dbsqp/bluetooth-reebok-57e/documentation/bike-power-traces.pdf

# ri I

10, o(20

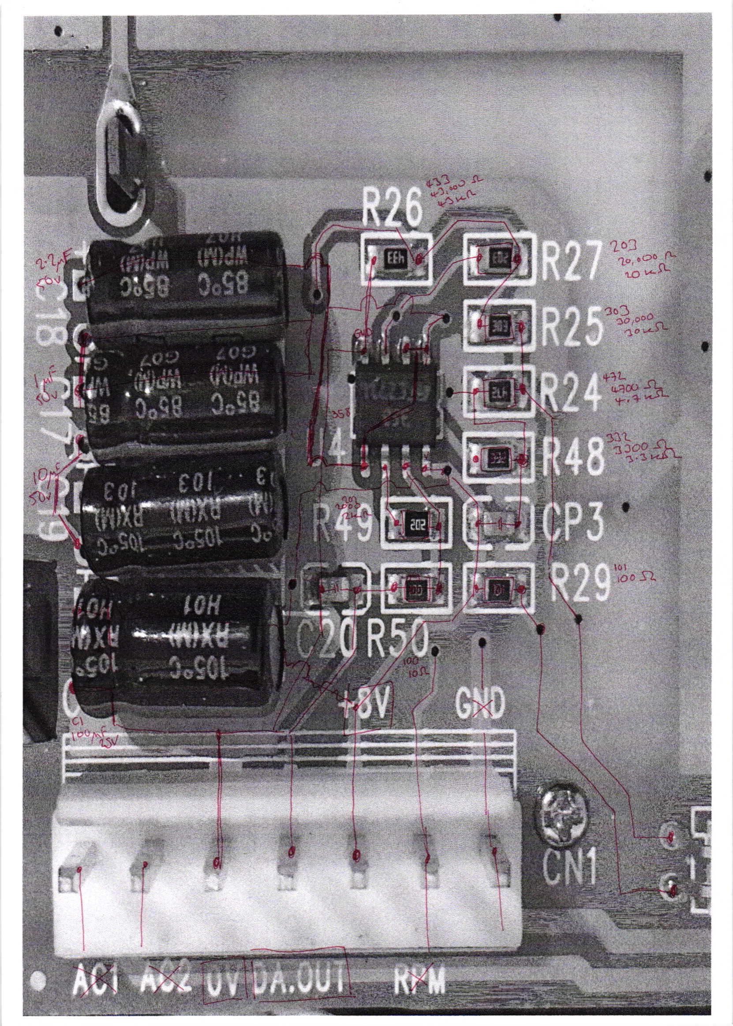
[picture p10: page 1]

*r

ri,

i(i

1a v-

L

il

il

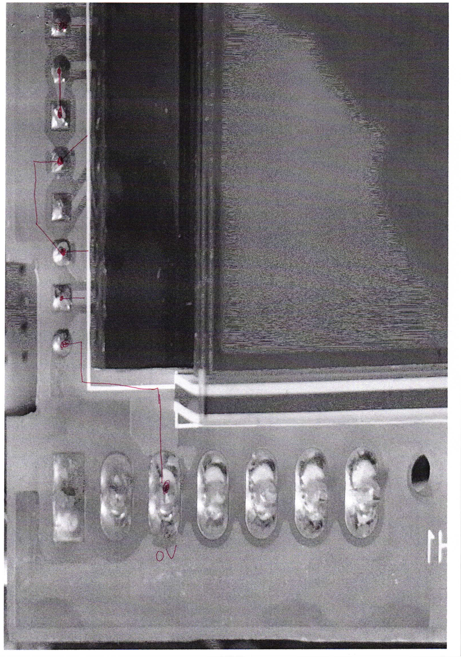
[picture p11: page 2]
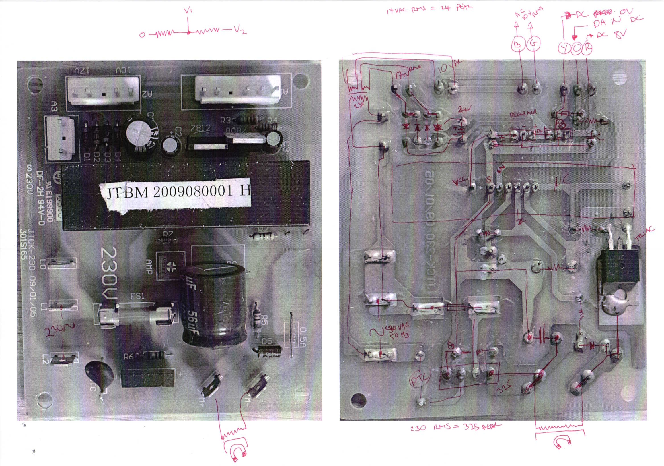
[picture p12: page 3]

+

-l7!>

T.t] @

f

I'

.<.J, I
{I

{-L

+'
o

-,

1

a -r .Lt(
:<. '..

i:

,C

.J

Lf

\q'- '

\.

lr
!(t
'ir

# qa) i

-li
