dbsqp/bluetooth-reebok-57e/documentation/Oscilloscope/ALL0000-oc-low/F0000TEK.pdf

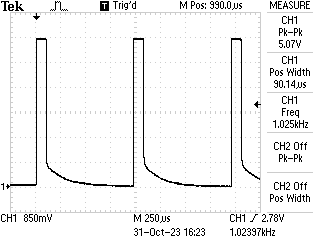
[picture p13: figure]
