dbsqp/bluetooth-reebok-57e/documentation/Oscilloscope/ALL0001-oc-high/F0001TEK.pdf

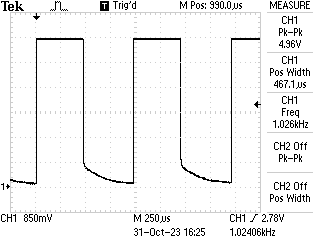
[picture p14: figure]
