dbsqp/bluetooth-reebok-57e/documentation/Oscilloscope/ALL0002-reed/F0002TEK.pdf

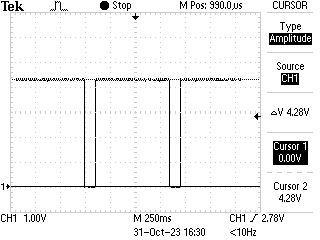
[picture p15: figure]
