dbsqp/bluetooth-reebok-57e/documentation/apple-watchos-bluetooth-csc.jpg

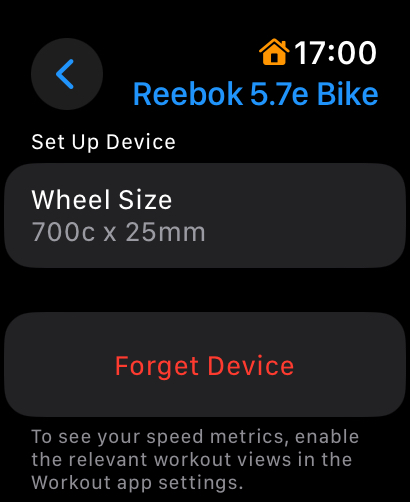
documentation/apple-watchos-bluetooth-csc.jpg
