dbsqp/bluetooth-reebok-57e/documentation/bike-electromagnet.jpeg

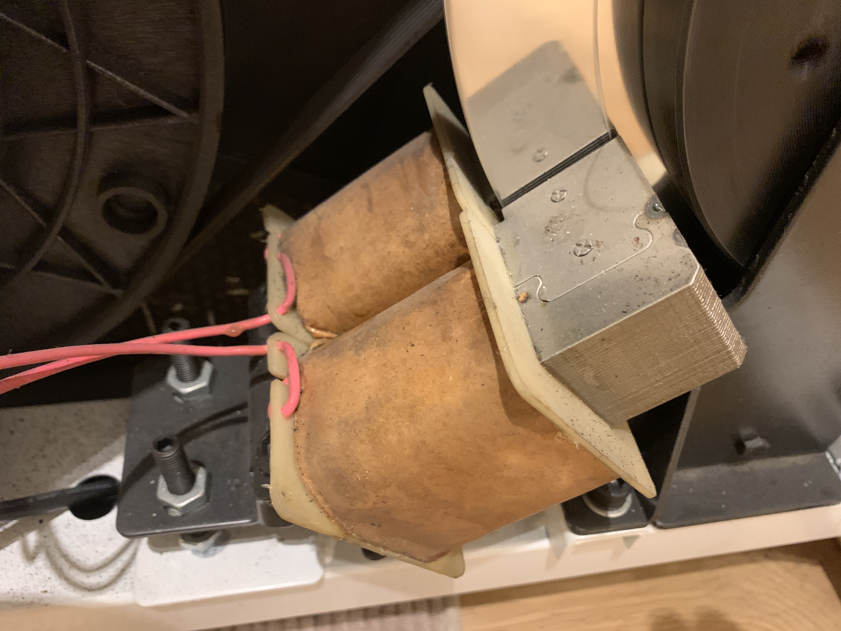
documentation/bike-electromagnet.jpeg
