dbsqp/bluetooth-reebok-57e/documentation/bike-mcu-CN3-daughter.jpeg

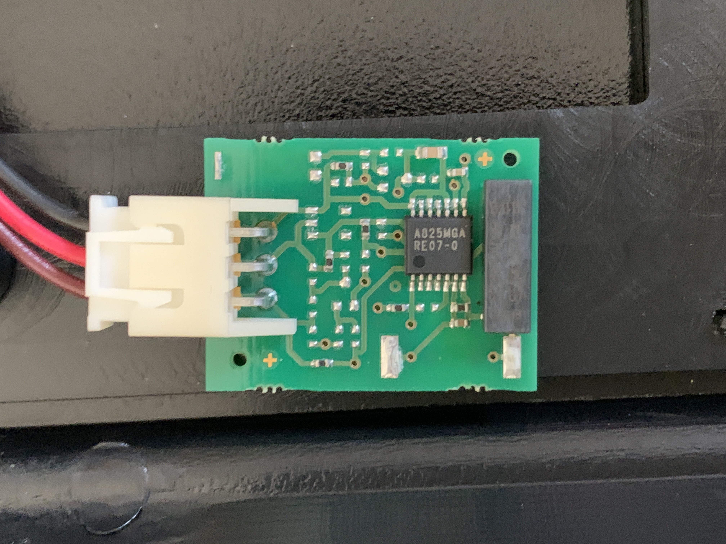
documentation/bike-mcu-CN3-daughter.jpeg
