dbsqp/bluetooth-reebok-57e/documentation/bike-mcu-CN4-serial.jpeg

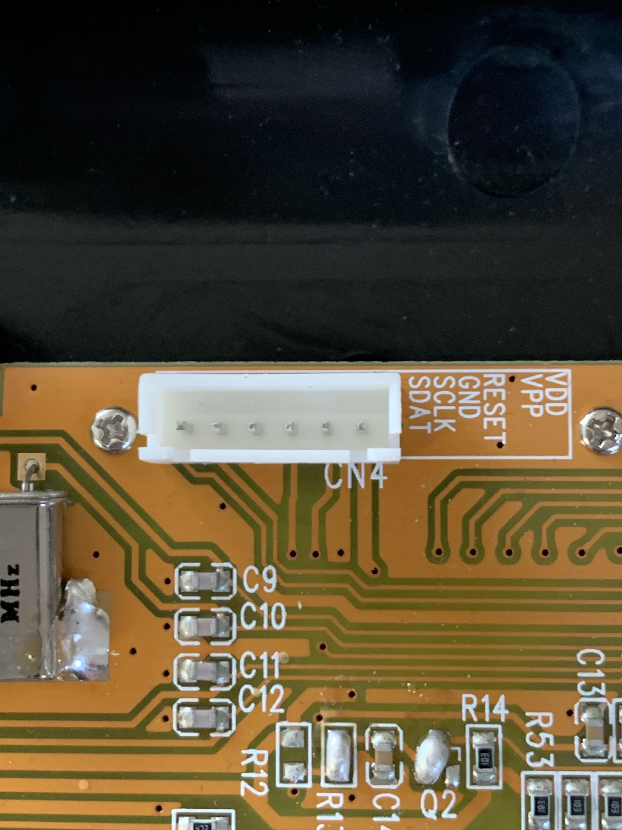
documentation/bike-mcu-CN4-serial.jpeg
