dbsqp/bluetooth-reebok-57e/documentation/bike-mcu-front.jpg

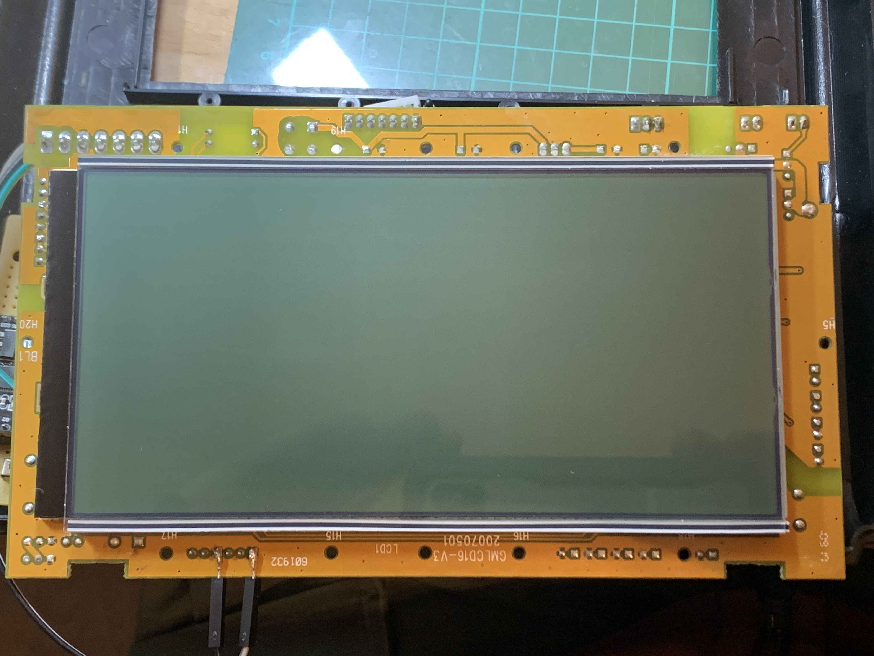
documentation/bike-mcu-front.jpg
