dbsqp/bluetooth-reebok-57e/documentation/bike-mcu-opamp-caps.jpeg

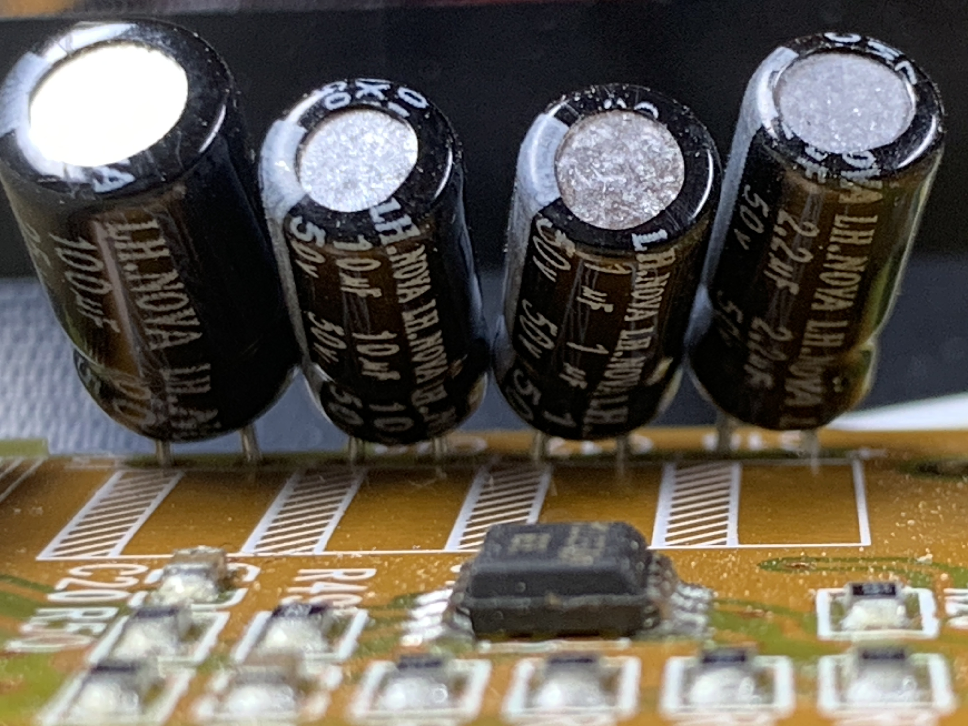
documentation/bike-mcu-opamp-caps.jpeg
