dbsqp/bluetooth-reebok-57e/documentation/bike-mcu-opamp-trace-front.jpg

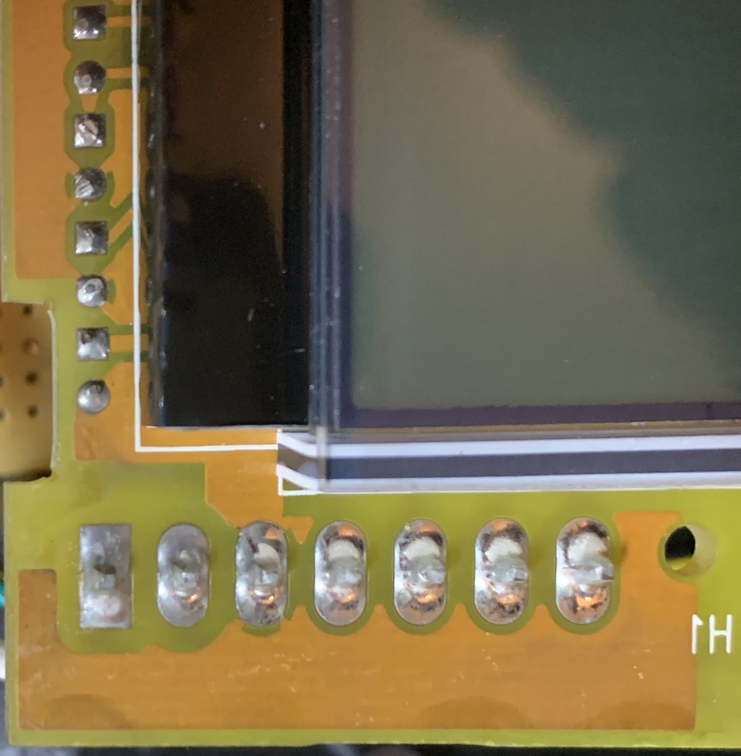
documentation/bike-mcu-opamp-trace-front.jpg
