dbsqp/bluetooth-reebok-57e/documentation/bike-mcu-opamp.jpg

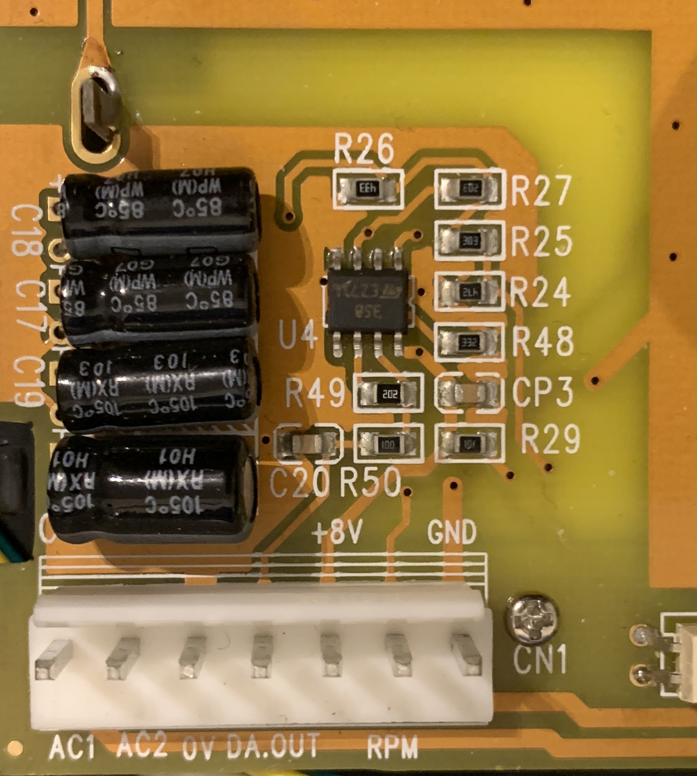
documentation/bike-mcu-opamp.jpg
