dbsqp/bluetooth-reebok-57e/documentation/bike-mcu-optio-P621-GR.jpg

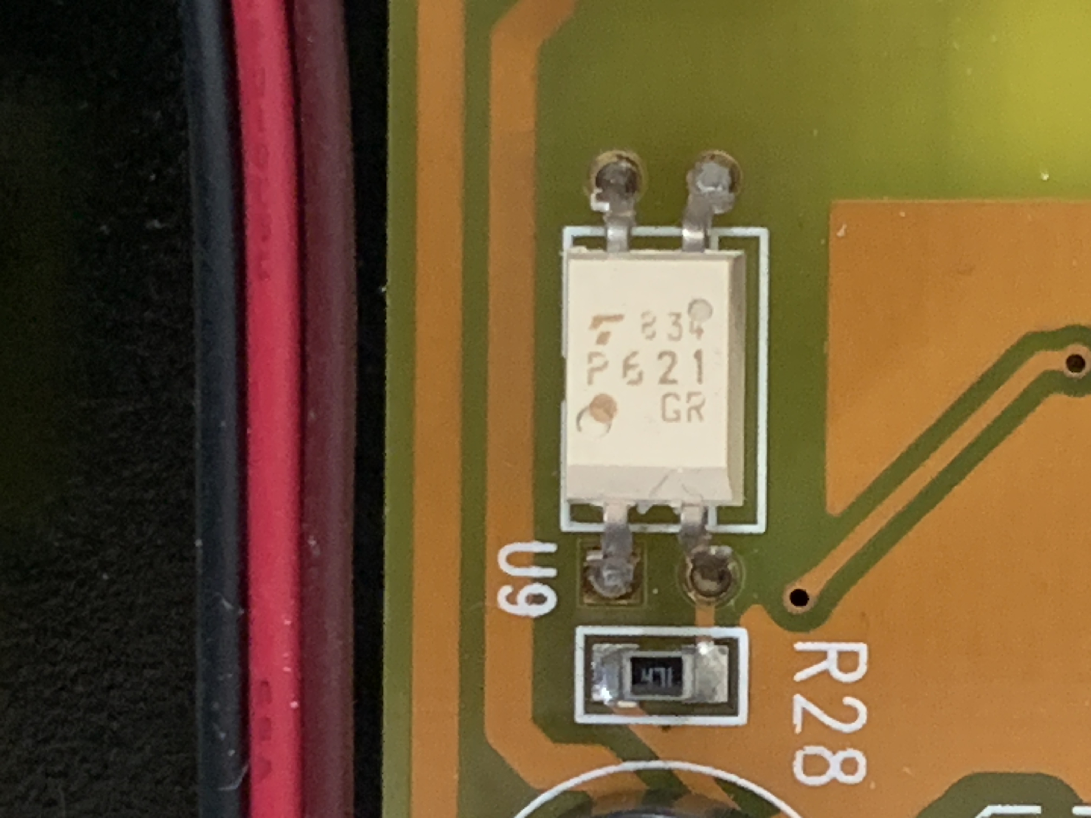
documentation/bike-mcu-optio-P621-GR.jpg
