dbsqp/bluetooth-reebok-57e/documentation/bike-mcu-regulator-7805.jpg

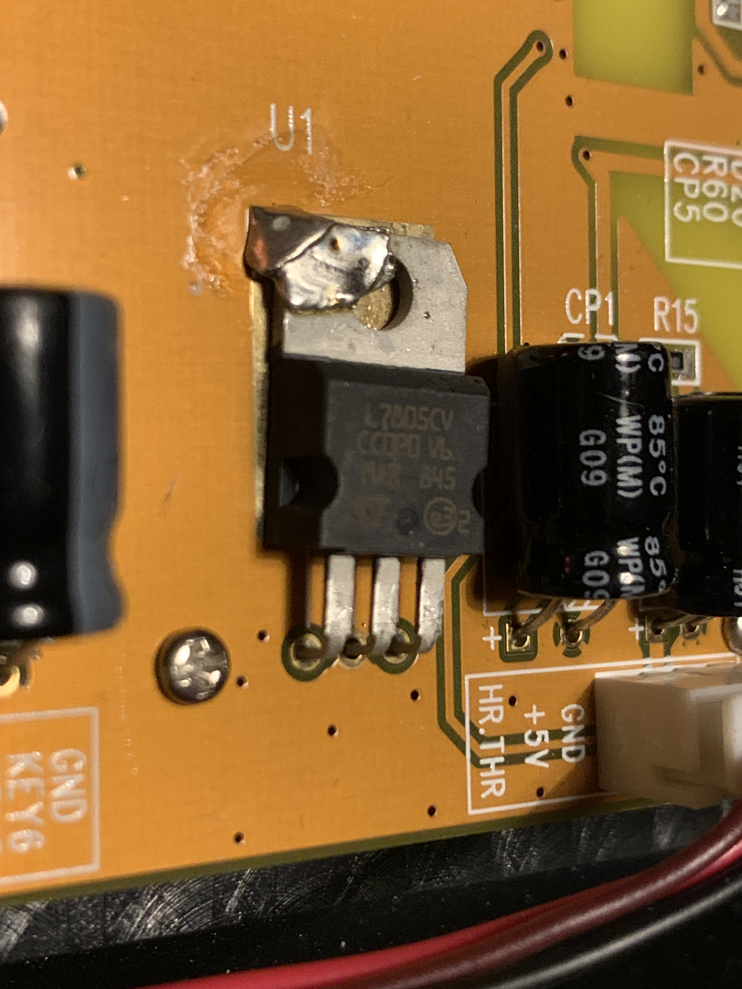
documentation/bike-mcu-regulator-7805.jpg
