dbsqp/bluetooth-reebok-57e/documentation/bike-mcu-signal-oc-high.jpeg

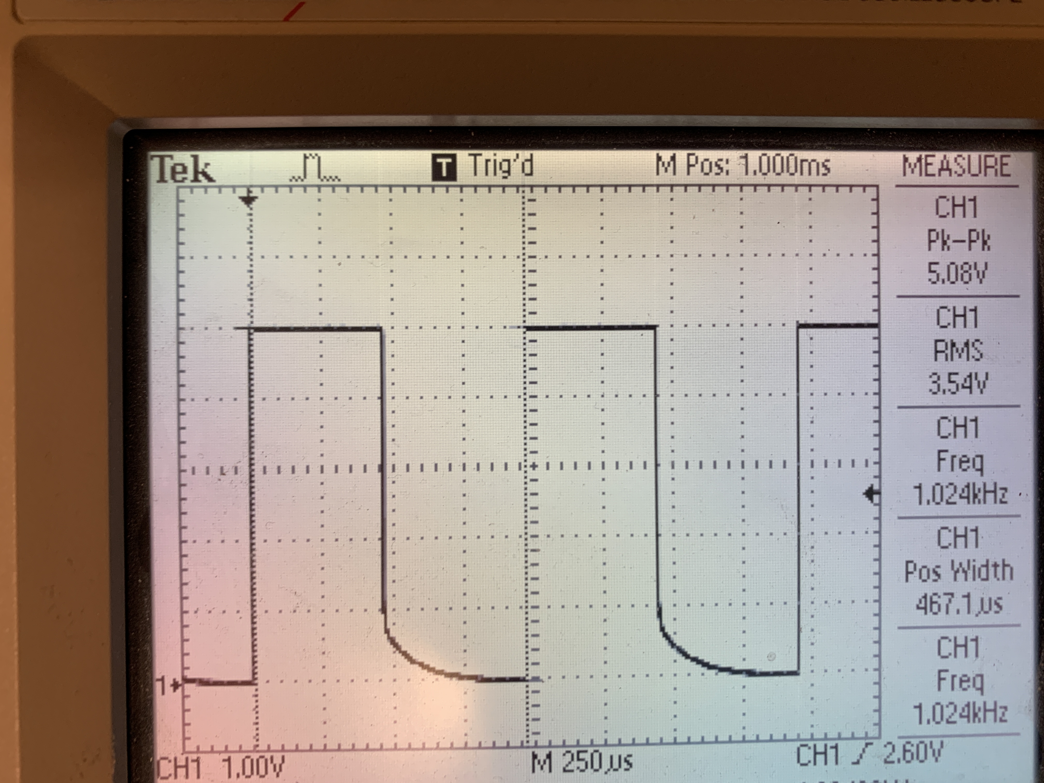
documentation/bike-mcu-signal-oc-high.jpeg
