dbsqp/bluetooth-reebok-57e/documentation/bike-mcu-signal-oc-low.jpeg

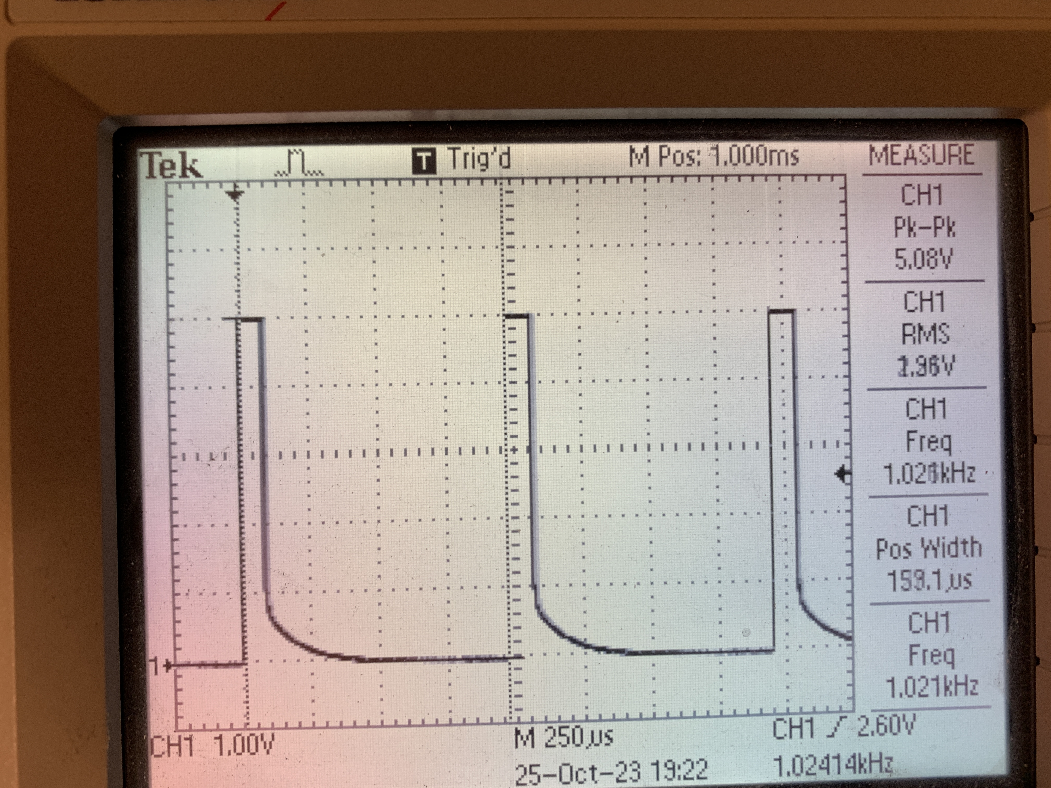
documentation/bike-mcu-signal-oc-low.jpeg
