dbsqp/bluetooth-reebok-57e/documentation/bike-mcu-signal-reed.jpg

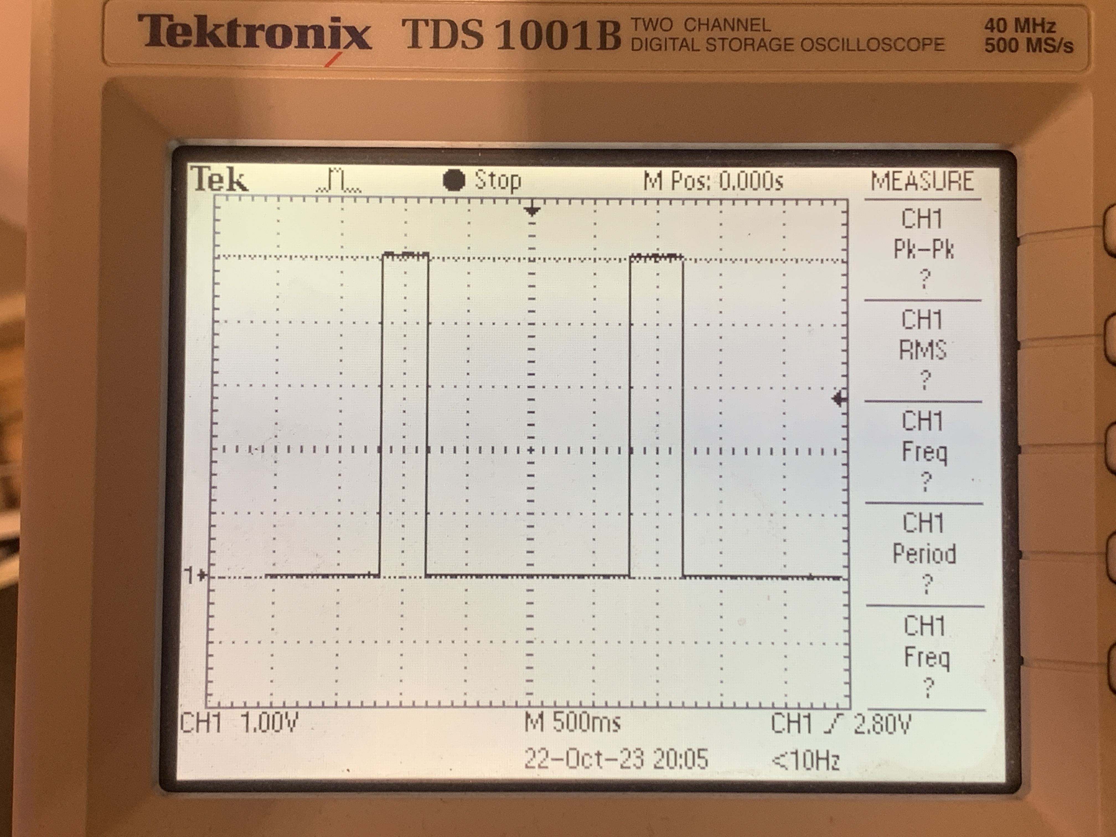
documentation/bike-mcu-signal-reed.jpg
