dbsqp/bluetooth-reebok-57e/documentation/bike-overview-full.png

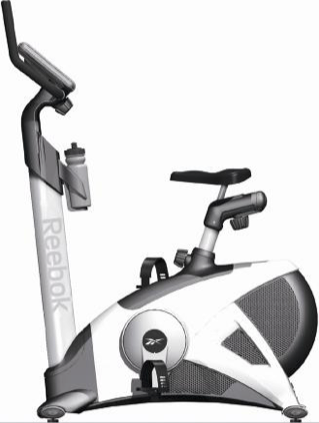
documentation/bike-overview-full.png
