dbsqp/bluetooth-reebok-57e/documentation/bike-overview.jpeg

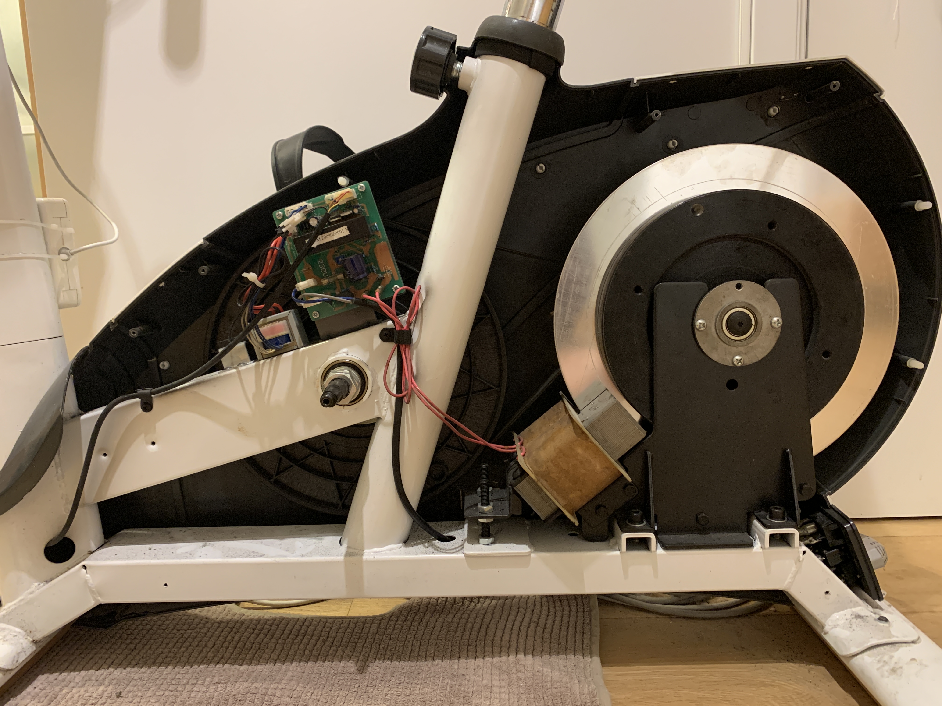
documentation/bike-overview.jpeg
