dbsqp/bluetooth-reebok-57e/documentation/bike-power-all.jpeg

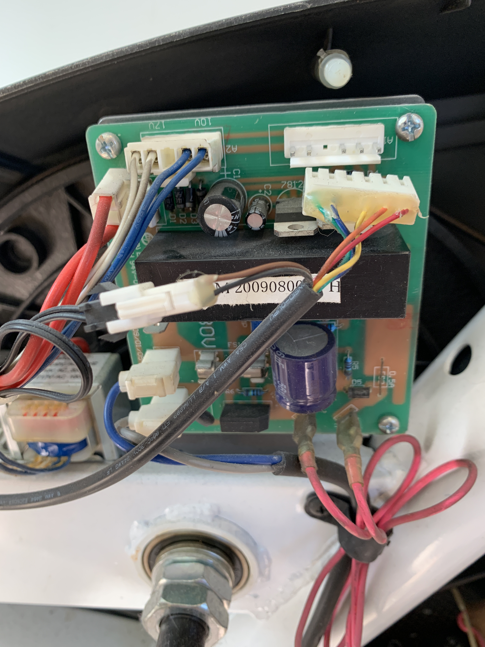
documentation/bike-power-all.jpeg
