dbsqp/bluetooth-reebok-57e/documentation/bike-power-front.jpeg

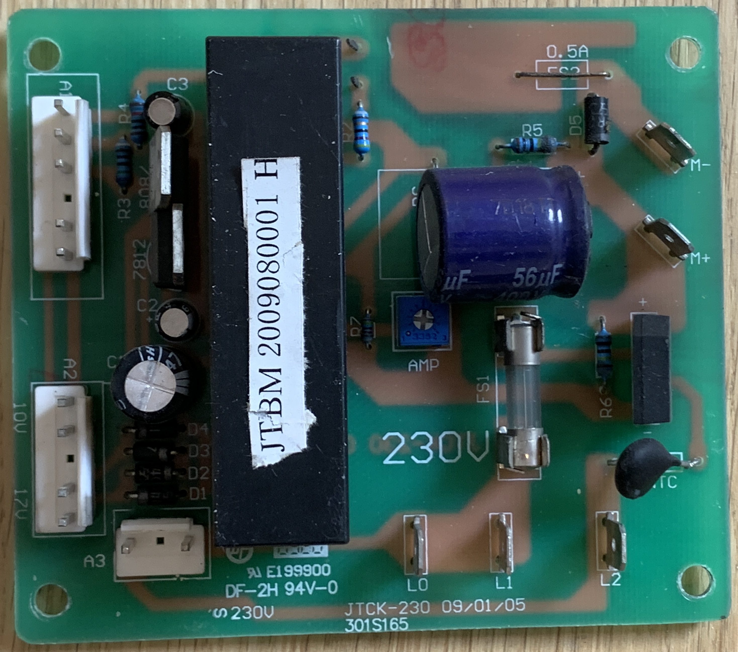
documentation/bike-power-front.jpeg
