dbsqp/bluetooth-reebok-57e/documentation/bike-power-reverse.jpeg

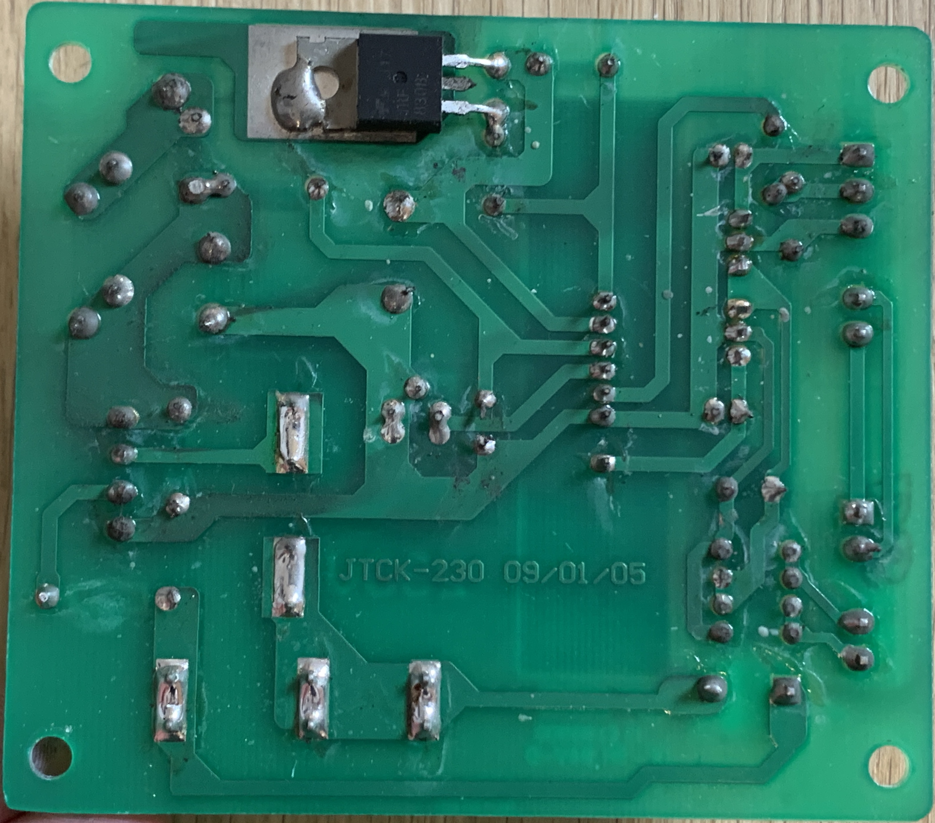
documentation/bike-power-reverse.jpeg
