dbsqp/bluetooth-reebok-57e/documentation/bike-power-trace-front.jpeg

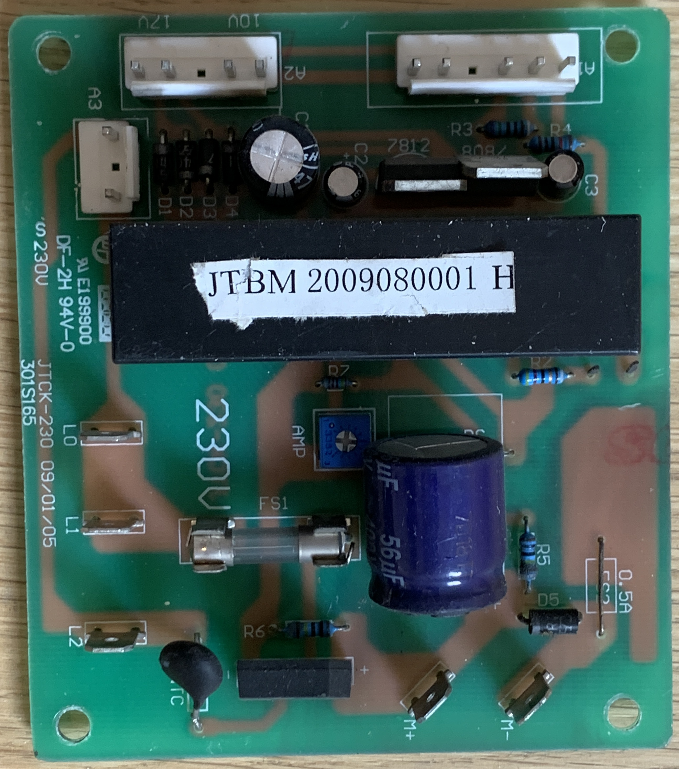
documentation/bike-power-trace-front.jpeg
