dbsqp/bluetooth-reebok-57e/documentation/bike-reed.jpeg

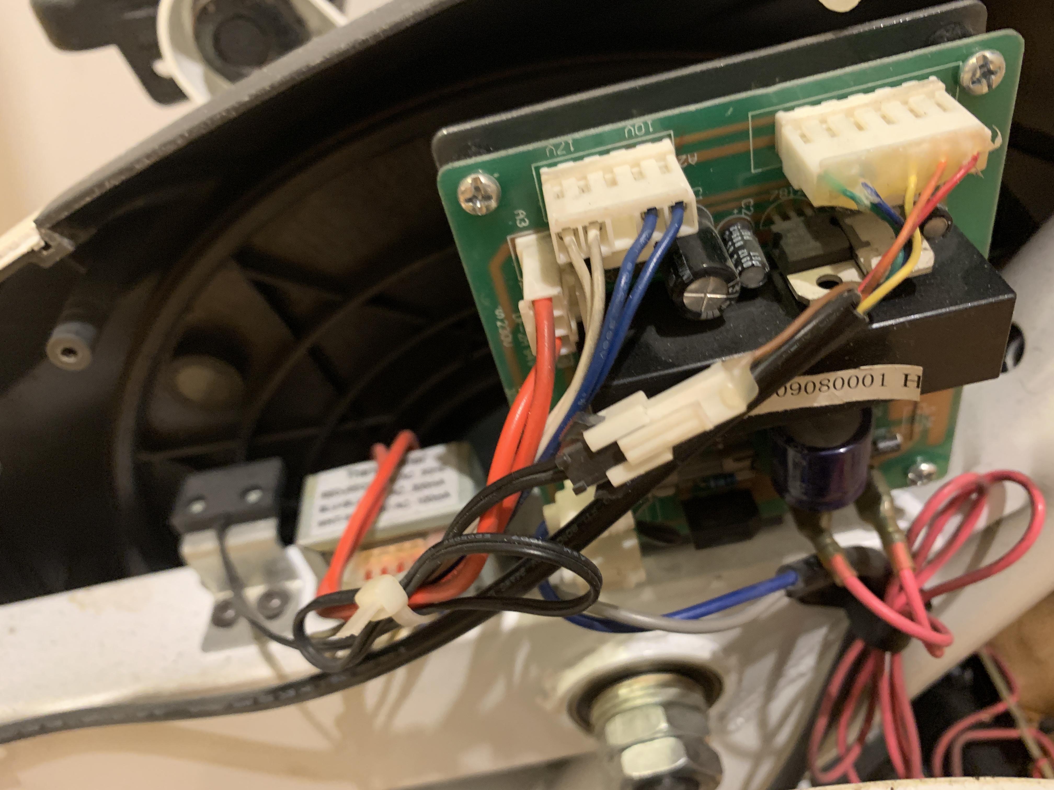
documentation/bike-reed.jpeg
