dbsqp/bluetooth-reebok-57e/documentation/comparison-bike.jpeg

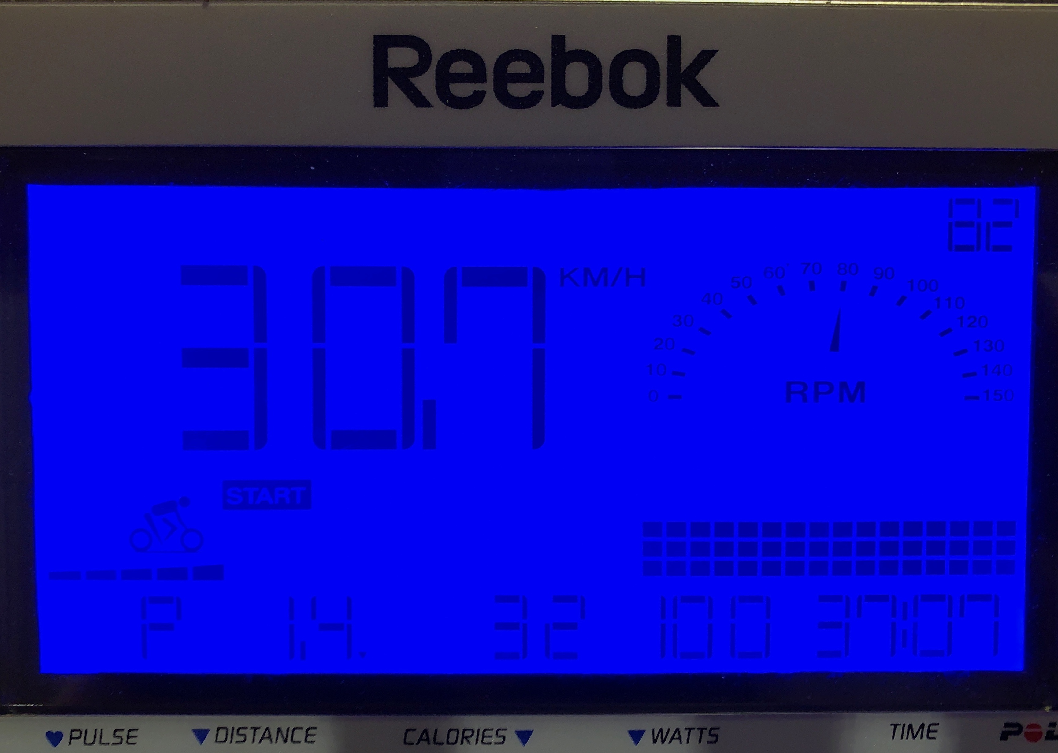
documentation/comparison-bike.jpeg
