dbsqp/bluetooth-reebok-57e/documentation/comparison-watch.jpeg

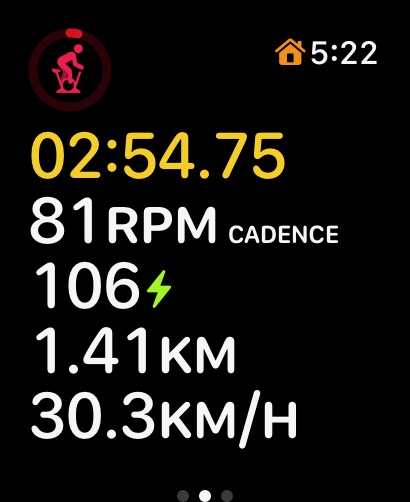
documentation/comparison-watch.jpeg
