dbsqp/bluetooth-reebok-57e/documentation/interface-front-mcu.jpeg

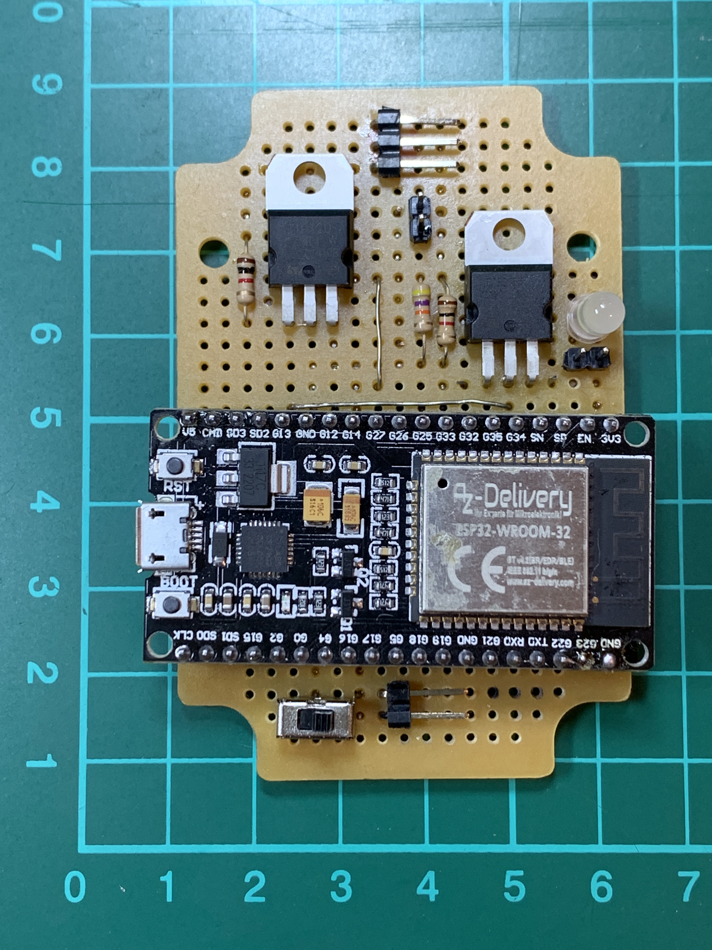
documentation/interface-front-mcu.jpeg
