dbsqp/bluetooth-reebok-57e/documentation/interface-front.jpeg

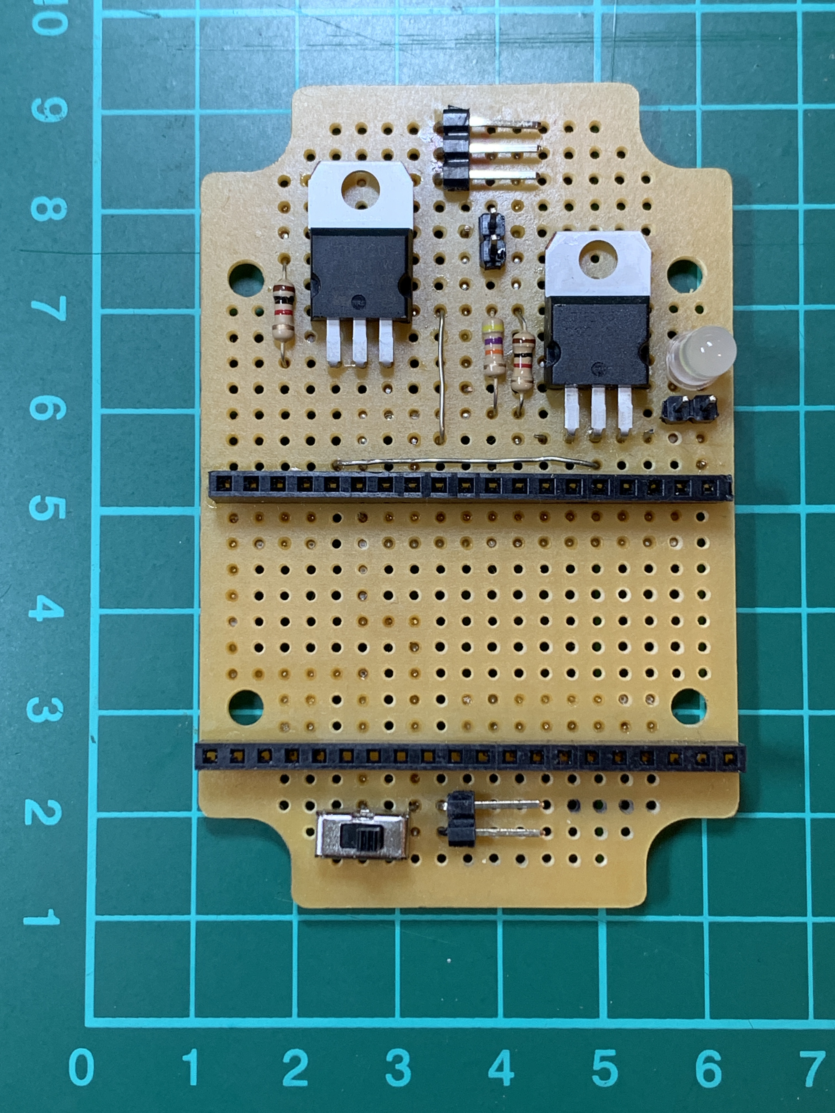
documentation/interface-front.jpeg
