dbsqp/bluetooth-reebok-57e/documentation/interface-reverse.jpeg

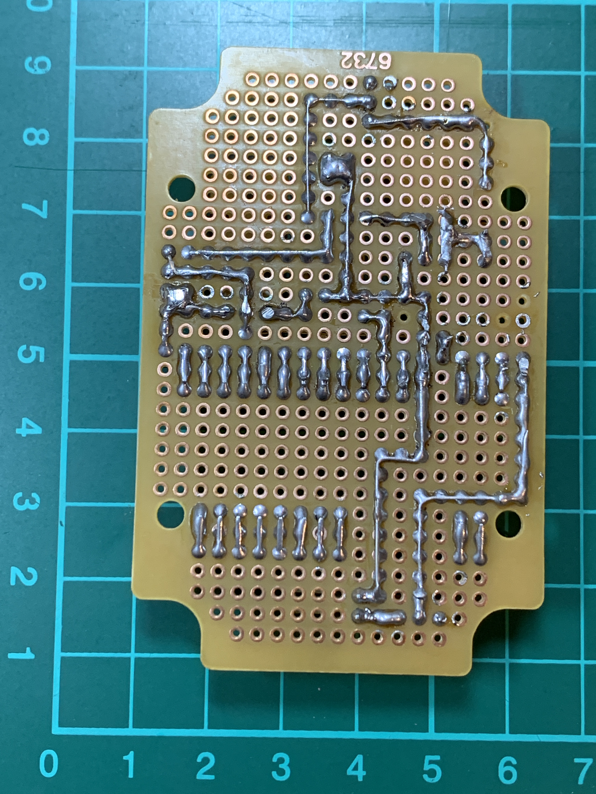
documentation/interface-reverse.jpeg
