dbsqp/bluetooth-reebok-57e/documentation/debug-workout-details.jpg

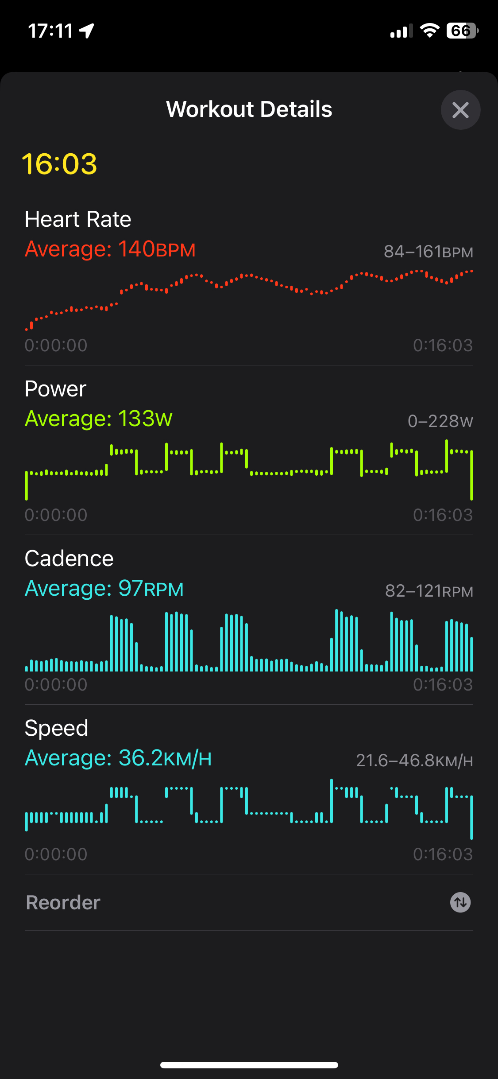
documentation/debug-workout-details.jpg
