dbsqp/bluetooth-reebok-57e/documentation/bike-exploded-edit.pdf

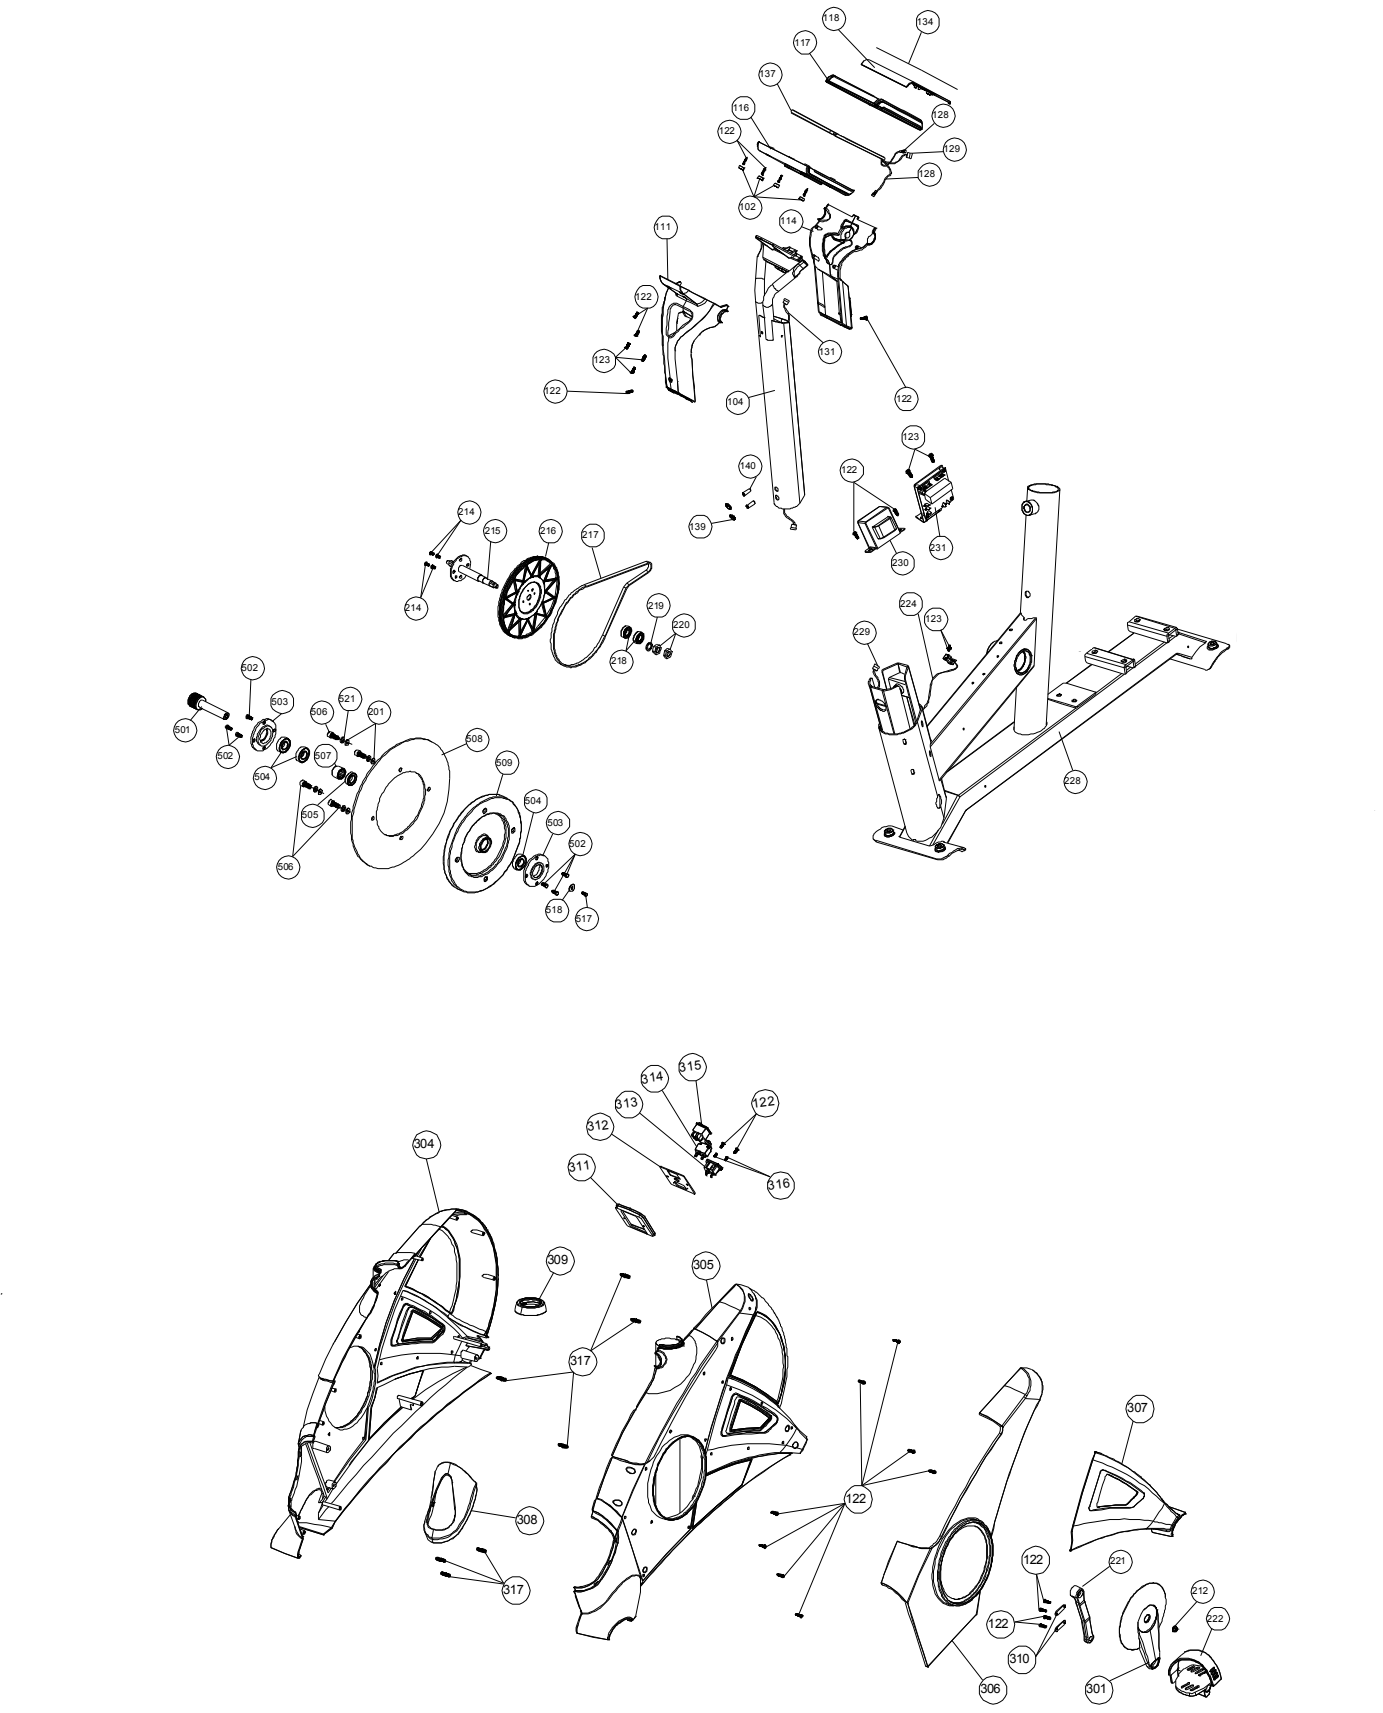
[picture p43: page 1]
