dbsqp/bluetooth-reebok-57e/documentation/bike-exploded-full.pdf

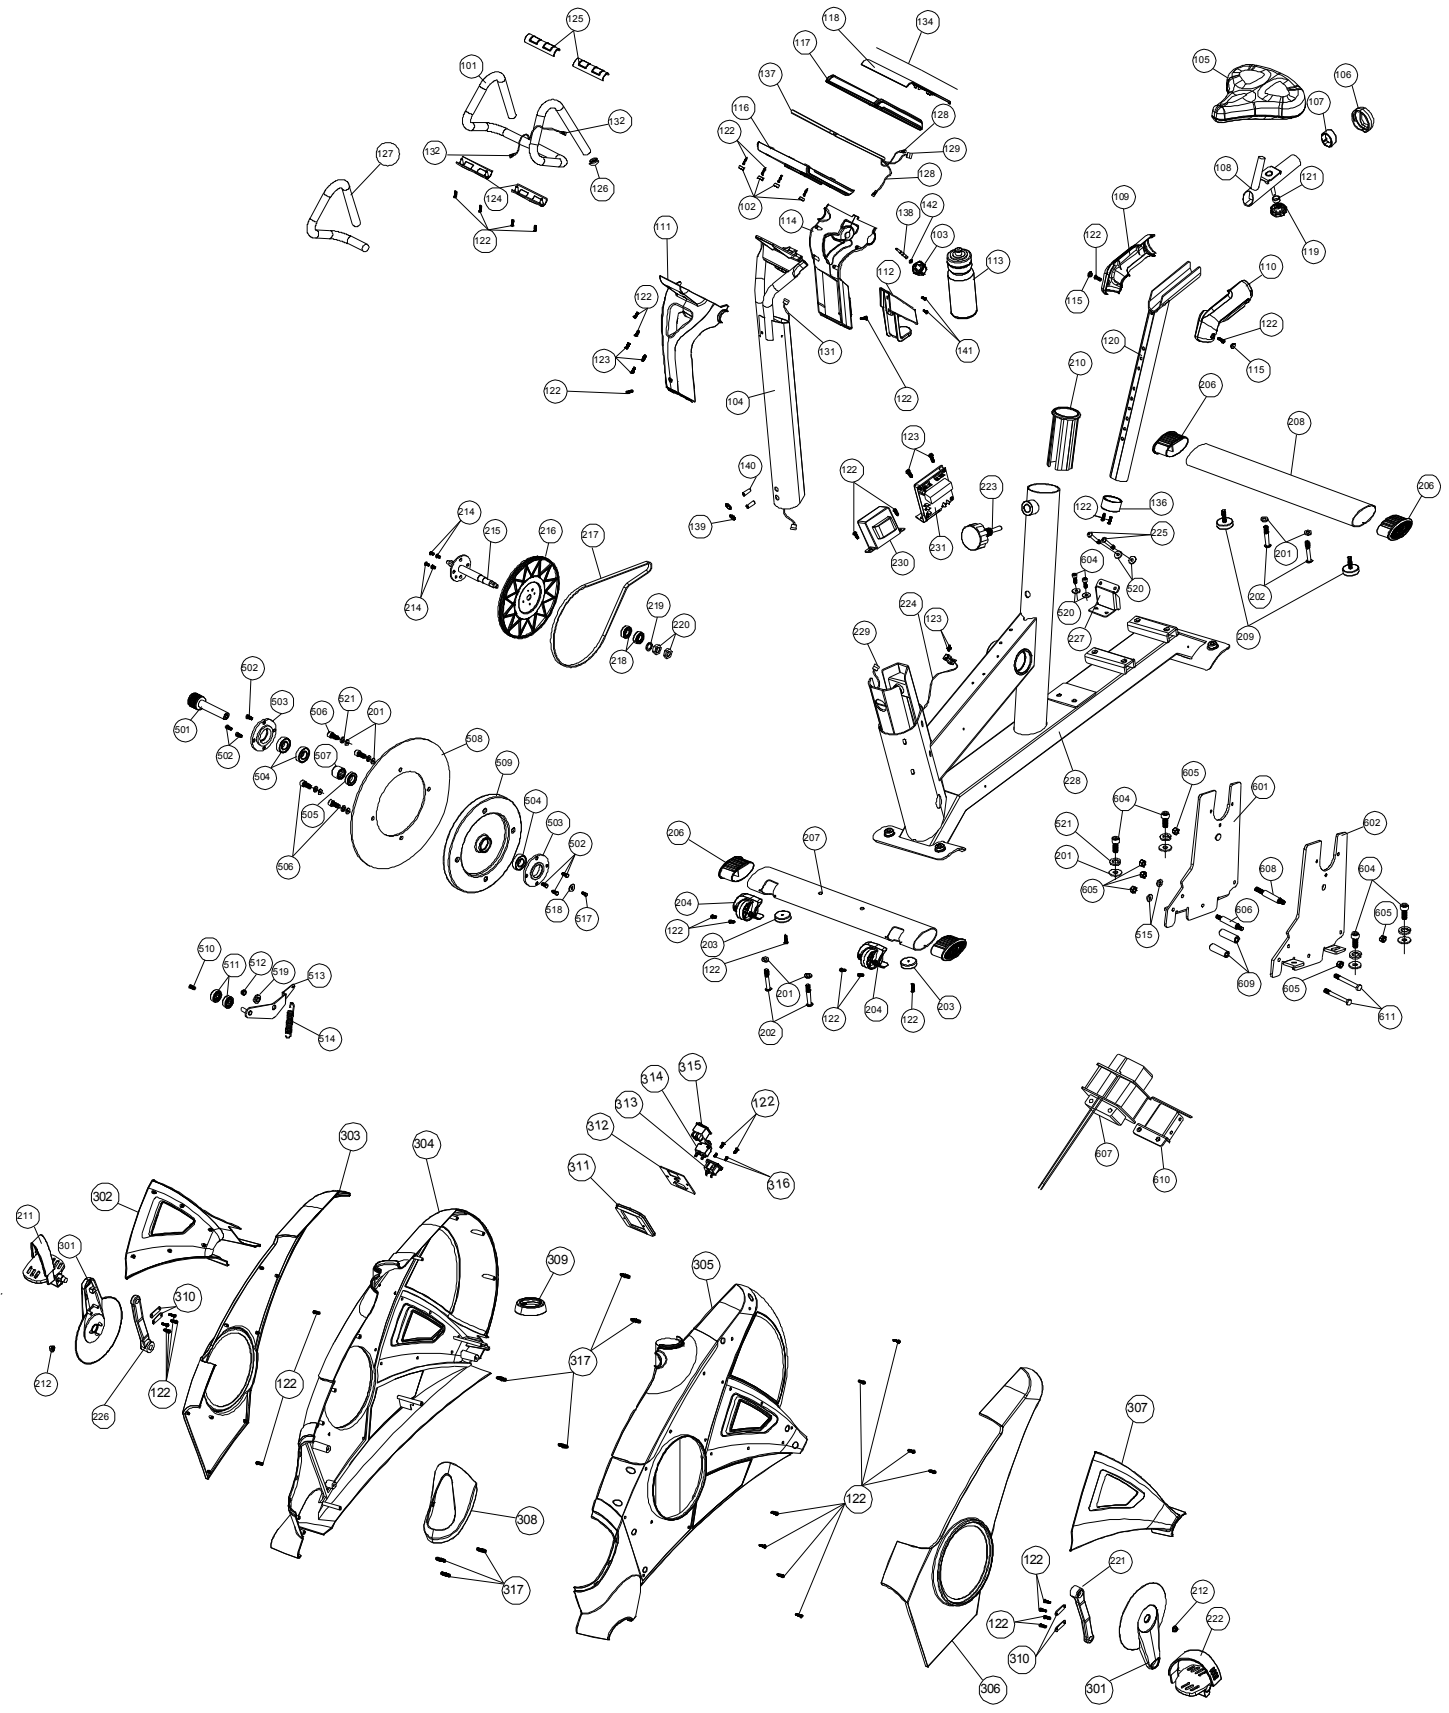
[picture p44: page 1]
