dbsqp/bluetooth-reebok-57e/(commit log)

2023-10-13 Update and rename Hall_Sensor_FTMS_server.ino to esp32-ftms-server-reebok-57e.ino
    Update filename and header info
2023-10-13 Rename esp32-ftms-server-reebok-57e.ino to ftms-reebok-57e.ino
    shorten name
2023-10-21 added power service
2023-10-21 power and cadence via CP service
2023-10-28 updated for rev sensor
2023-11-05 resistance duty-cycle and sleep
2023-11-08 report cadance, speed and approx power
2023-11-08 added hall efect sensor
2023-11-09 fix bug & serial out
    [bluetooth-reebok-57e.ino]
2023-11-17 added power function
    [bike-power-function.xlsx]
