dbsqp/bluetooth-reebok-57e/documentation/bike-mcu-CN1-inputs.jpeg

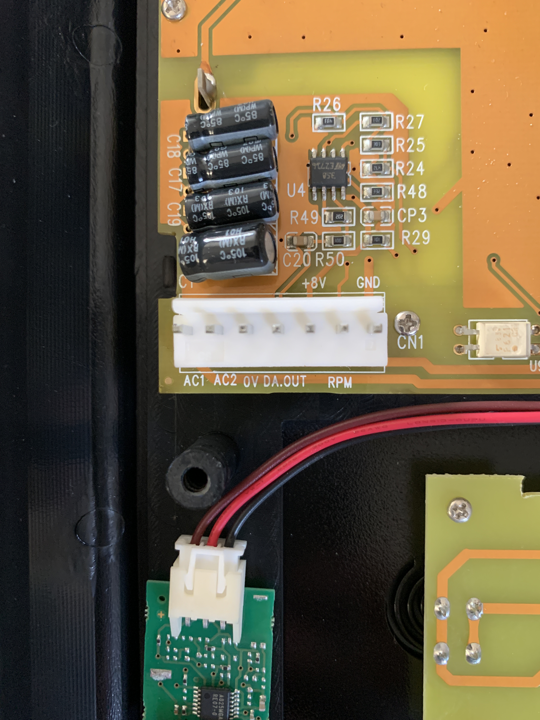
documentation/bike-mcu-CN1-inputs.jpeg
